junhee0110/DAYONE_drone/modeling/1590045909.jpg

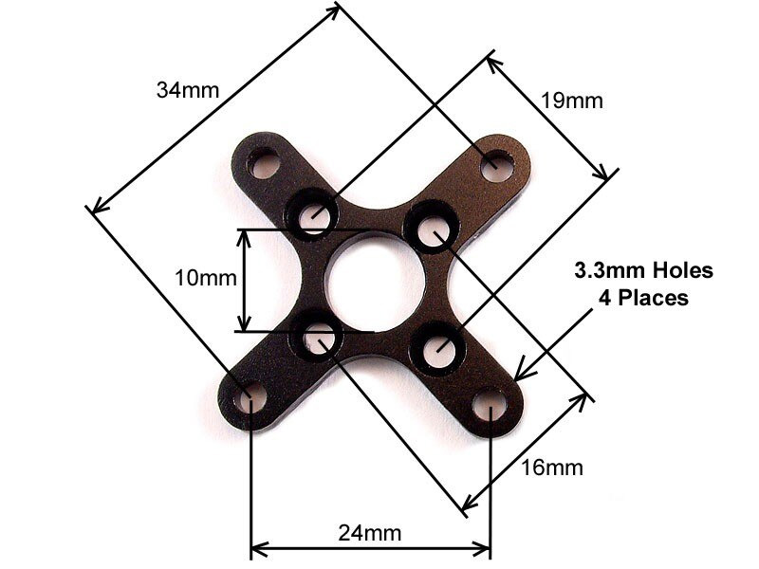
modeling/1590045909.jpg
