junhee0110/DAYONE_drone/sketch_201104a/data/background.PNG

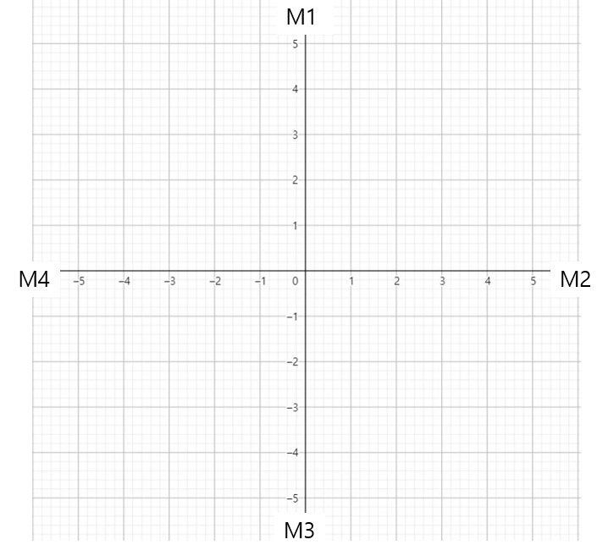
sketch_201104a/data/background.PNG
