junhee0110/DAYONE_drone/modeling/[V2.2]Drone_Body(sep).SLDASM

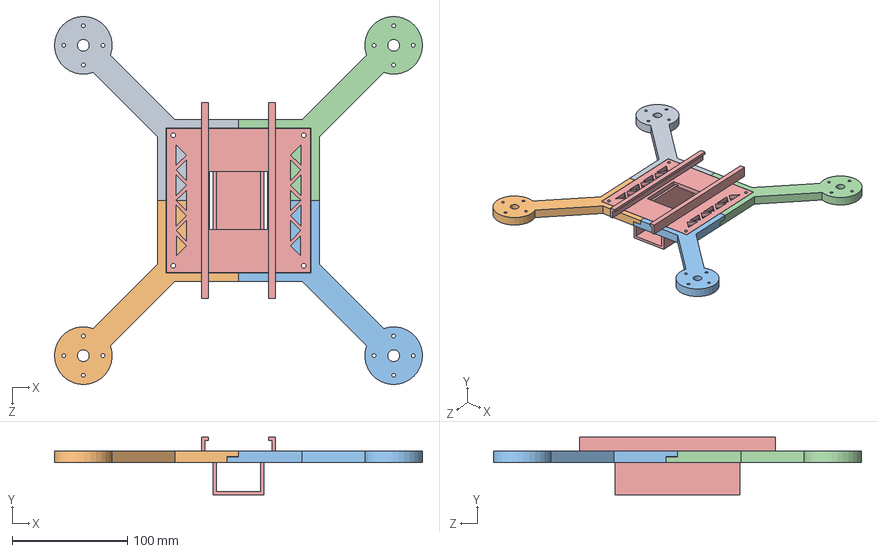
[picture p3: CAD file, 2021-02-21]
modeling/[V2.2]Drone_Body(sep).SLDASM
318.6 x 50.0 x 318.6 mm
[V2.2]Drone_Body(1)
[V2.2]Drone_Body(2)
[V2.2]Drone_Body(3)
[V2.2]Drone_Body(4)
[V2.2]Drone_FCtrl
