junhee0110/DAYONE_drone/modeling/Drone_Body.SLDASM

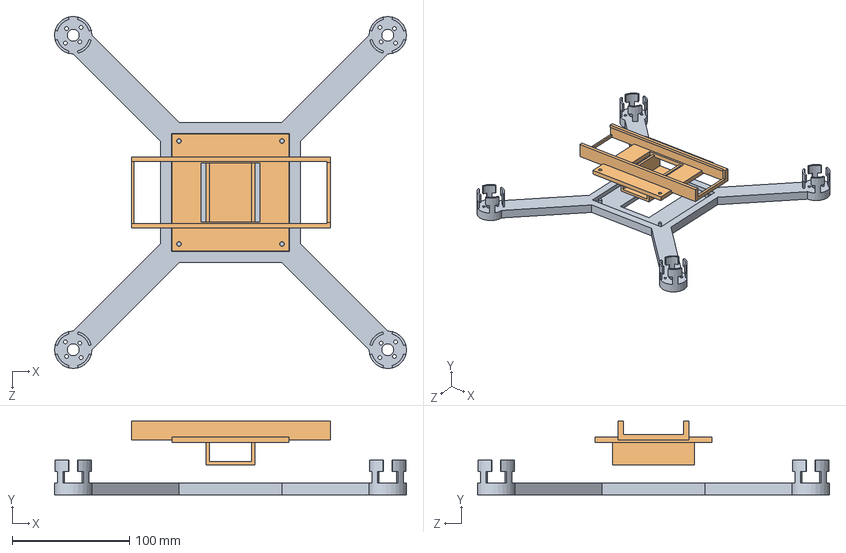
[picture p4: CAD file, 2021-01-31]
modeling/Drone_Body.SLDASM
300.7 x 63.1 x 300.7 mm
Drone_Body
Drone_FCtrl
