junhee0110/DAYONE_drone/modeling/Drone_Body(sep).SLDASM

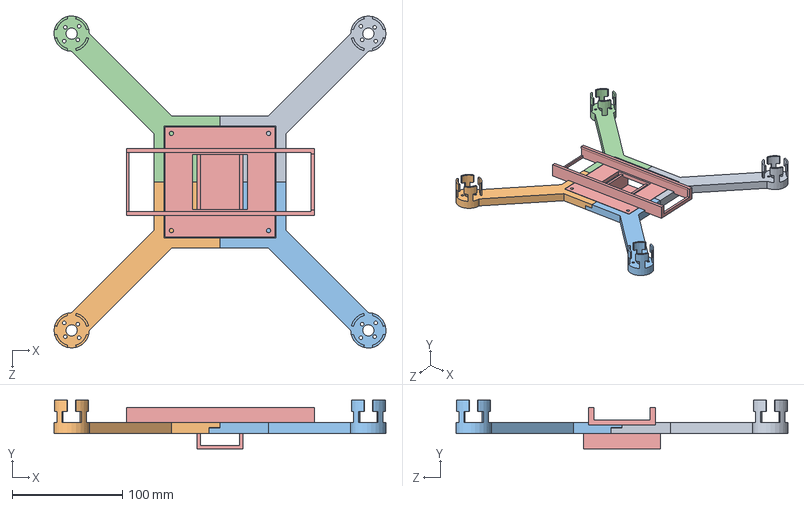
[picture p5: CAD file, 2021-01-31]
modeling/Drone_Body(sep).SLDASM
300.7 x 44.0 x 300.7 mm
Drone_Body(1)
Drone_Body(2)
Drone_Body(3)
Drone_Body(4)
Drone_FCtrl
