junhee0110/DAYONE_drone/modeling/[V2.2]Drone_Body.SLDPRT

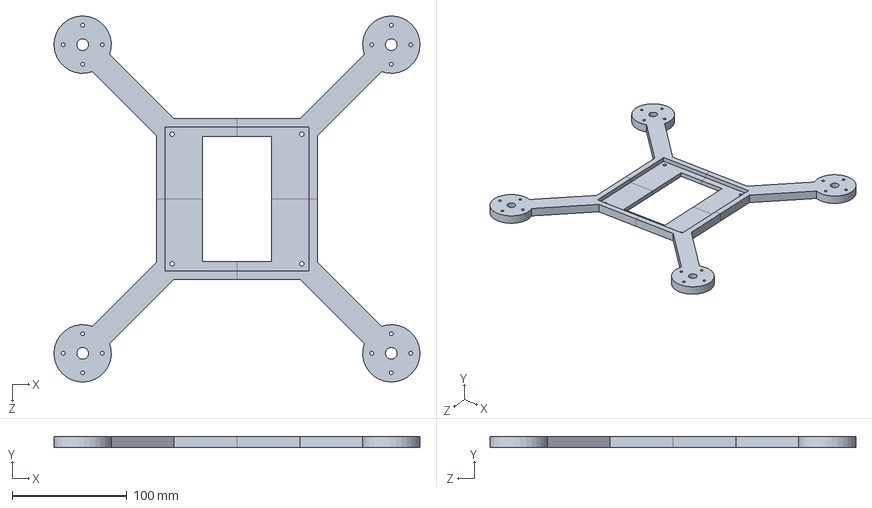
[picture p6: CAD file, 2021-02-21]
modeling/[V2.2]Drone_Body.SLDPRT
318.6 x 10.0 x 318.6 mm
