junhee0110/DAYONE_drone/modeling/STL for Printing/[V2.2]Drone_Body(1).STL

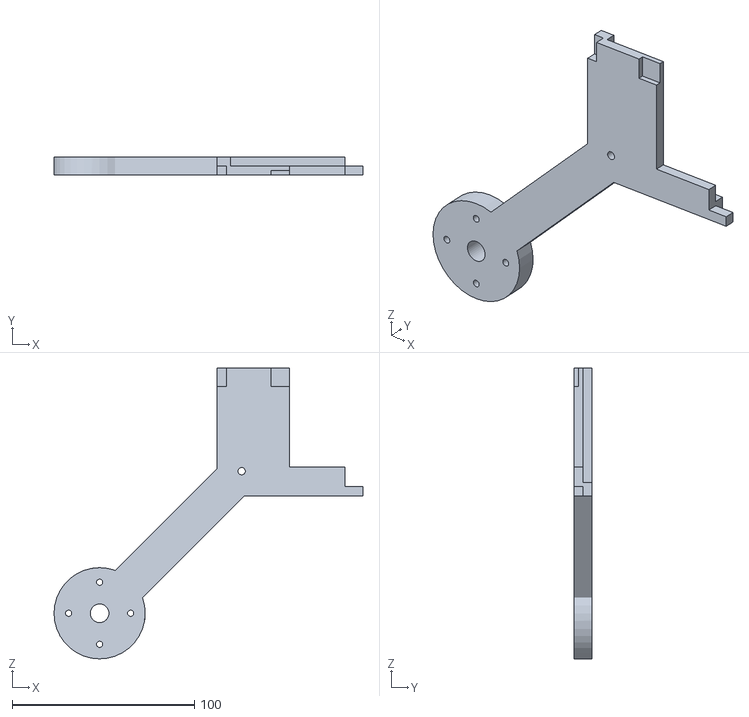
[picture p7: CAD file, 2021-02-21]
modeling/STL for Printing/[V2.2]Drone_Body(1).STL
169.4 x 10.0 x 159.4
