junhee0110/DAYONE_drone/modeling/STL for Printing/[V2.2]Drone_FCtrl.STL

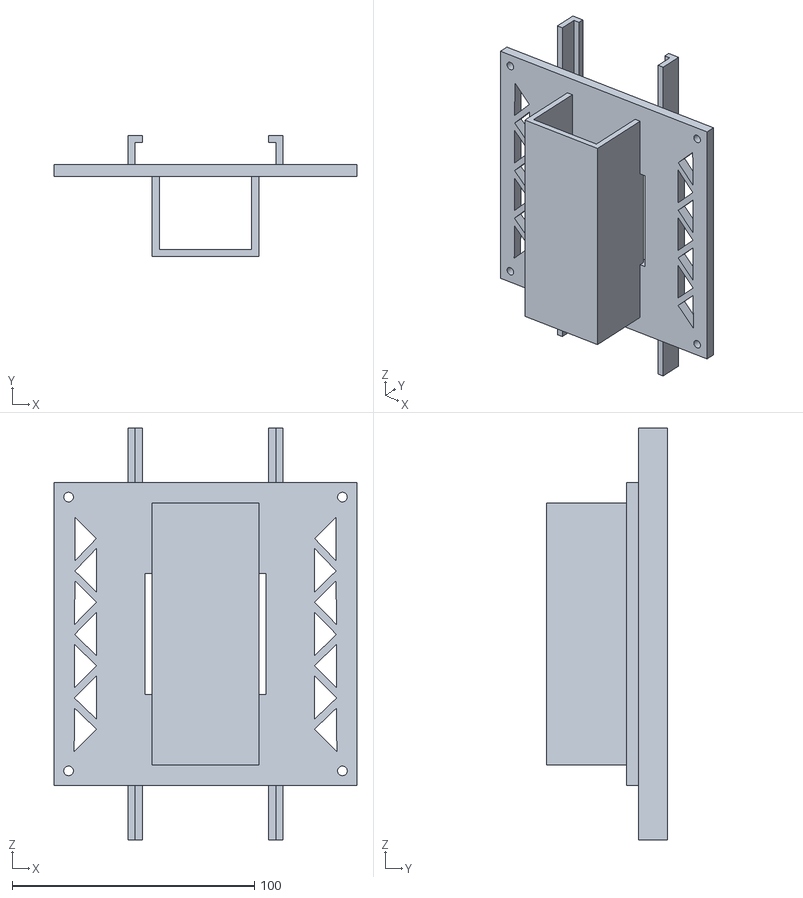
[picture p8: CAD file, 2021-02-21]
modeling/STL for Printing/[V2.2]Drone_FCtrl.STL
125.0 x 50.0 x 170.0
