junhee0110/DAYONE_drone/modeling/Drone_FCtrl(PBoard).SLDPRT

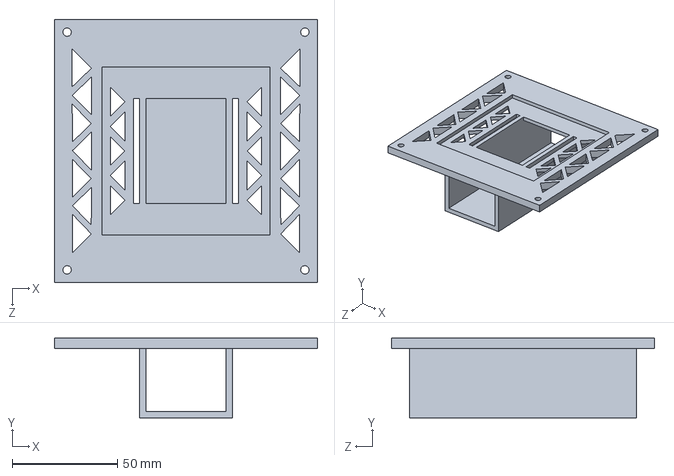
[picture p9: CAD file, 2021-02-21]
modeling/Drone_FCtrl(PBoard).SLDPRT
125.0 x 38.0 x 125.0 mm
