junhee0110/DAYONE_drone/modeling/[V2.1]Drone_Body(3).SLDPRT

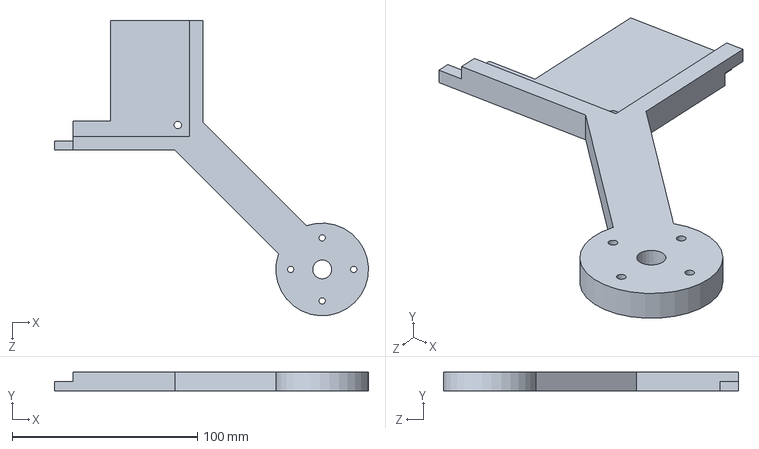
[picture p10: CAD file, 2021-02-11]
modeling/[V2.1]Drone_Body(3).SLDPRT
169.3 x 10.0 x 159.3 mm
