junhee0110/DAYONE_drone/modeling/STL for Printing/Drone_Body.STL

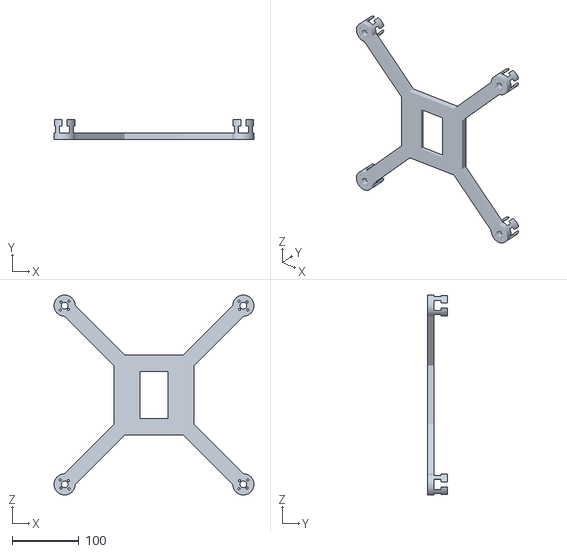
[picture p11: CAD file, 2021-01-29]
modeling/STL for Printing/Drone_Body.STL
300.7 x 30.0 x 300.7
