junhee0110/DAYONE_drone/modeling/STL for Printing/Drone_FCtrl.STL

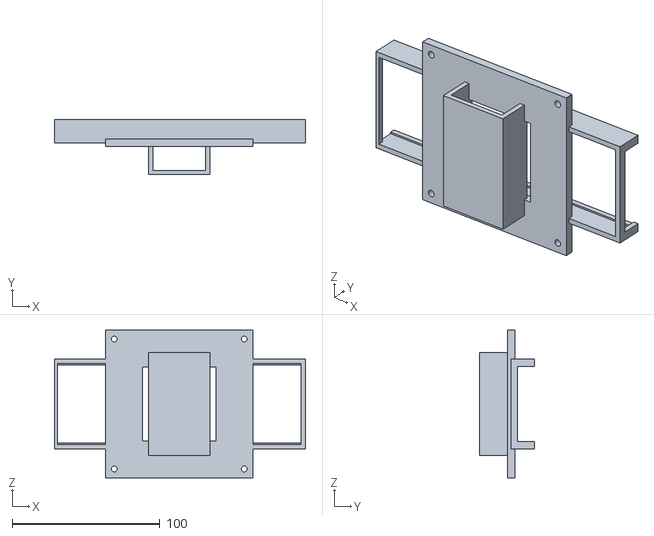
[picture p12: CAD file, 2021-01-20]
modeling/STL for Printing/Drone_FCtrl.STL
170.0 x 37.5 x 100.0
