junhee0110/DAYONE_drone/modeling/드론_모터.SLDPRT

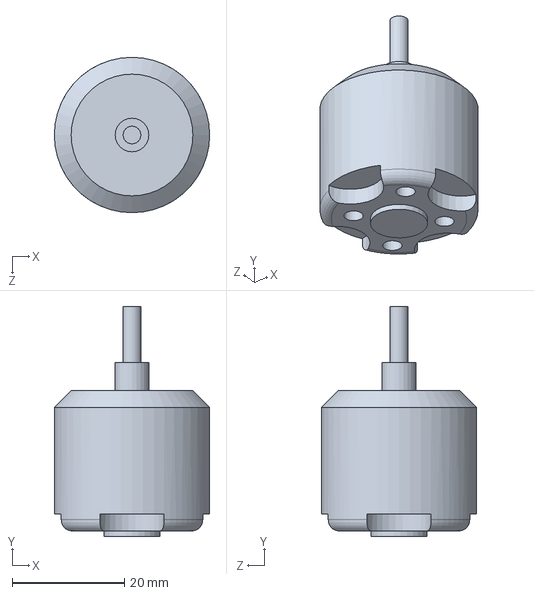
[picture p13: CAD file, 2021-01-06]
modeling/드론_모터.SLDPRT
27.7 x 41.0 x 27.7 mm
