junhee0110/DAYONE_drone/(list of files, cad)

Other CAD files:
modeling/STL for Printing/[V2.2]Drone_Body(2).STL
modeling/STL for Printing/[V2.2]Drone_Body(3).STL
modeling/STL for Printing/[V2.2]Drone_Body(4).STL
modeling/[V2.2]Drone_FCtrl.SLDPRT
modeling/[V2.1]Drone_Body(4).SLDPRT
modeling/[V2.1]Drone_Body(1).SLDPRT
modeling/[V2.1]Drone_Body(2).SLDPRT
modeling/Drone_FCtrl.SLDPRT
modeling/A2212 13 1000KV.3dm
modeling/Drone_Body(1).SLDPRT
modeling/Drone_Body(2).SLDPRT
modeling/Drone_Body(3).SLDPRT
modeling/Drone_Body(4).SLDPRT
modeling/Drone_Body.SLDPRT
modeling/Drone_FCtrl.SLDDRW
modeling/STL for Printing/Drone_Body(1).STL
modeling/STL for Printing/Drone_Body(2).STL
modeling/STL for Printing/Drone_Body(3).STL
modeling/STL for Printing/Drone_Body(4).STL
modeling/STL for Printing/[V2.1]Drone_Body(1).STL
modeling/STL for Printing/[V2.1]Drone_Body(2).STL
modeling/STL for Printing/[V2.1]Drone_Body(3).STL
modeling/STL for Printing/[V2.1]Drone_Body(4).STL
modeling/STL for Printing/[V2]Drone_Body(1).STL
modeling/STL for Printing/[V2]Drone_Body(2).STL
modeling/STL for Printing/[V2]Drone_Body(3).STL
modeling/STL for Printing/[V2]Drone_Body(4).STL
modeling/STL for Printing/[V2]Drone_FCtrl.STL
modeling/[V2.1]Drone_Body(sep).SLDASM
modeling/[V2.2]Drone_Body(1).SLDPRT
modeling/[V2.2]Drone_Body(2).SLDPRT
modeling/[V2.2]Drone_Body(3).SLDPRT
modeling/[V2.2]Drone_Body(4).SLDPRT
modeling/[V2]Drone_Body(1).SLDPRT
modeling/[V2]Drone_Body(2).SLDPRT
modeling/[V2]Drone_Body(3).SLDPRT
modeling/[V2]Drone_Body(4).SLDPRT
modeling/[V2]Drone_Body(sep).SLDASM
modeling/[V2]Drone_Body.SLDPRT
modeling/[V2]Drone_FCtrl.SLDPRT
