junhee0110/DAYONE_drone/(threads)

Thread 11 (2021-02-03):

프로젝트 진행 기록 문서 작성

junhee0110, 2021-02-03:
# 이슈 요약
2021-02-03 모임에서 이야기했듯, 이제 프로젝트 문서 작성을 확실히 하고자 합니다.
일단 지금까지의 기록을 제가 정리할 예정입니다.

# 이슈 발행 배경
시간이 오래 지나면서 우리의 초기 기획안을 다들 잊어버리고 있기도하고, 그것을 명확하게 기록해두지 않아 소통에 문제가 생긴 경우가 많았습니다. 또한, 우리의 시행착오와 아이디어를 기록해두는 편이 앞으로도 도움이 될 것같아서 프로젝트의 결과와 과정에 대한 문서를 확실히 작성하고자 합니다.

# 이슈 설명
프로젝트 문서에는 다음과 같은 내용을 작성합니다.
- 초기 아이디어 및 목표
- 사용하고 있는 부품
- 소프트웨어 설명
- 시행착오 및 해결

지금까지의 내용은 제가 작성하지만, 앞으로의 작성을 위해서 여러분이 틈틈히 작성을 해주셔야 합니다.
다음과 같이 작성 부탁드립니다.
- 작성하고 있는 프로그램 코드의 상단에 주석으로 설명기재
- 현재 진행하고 있는 작업을 Issue에 상세히 기록
- 문제가 생기거나 도움이 필요할 때 Issue에 상세히 기록
- Issue 발행시 레퍼런스도 기록

**결국 핵심은 Issue를 상세히 기록하는 것이니 동참바랍니다!!**

Thread 12 (2021-02-03):

[Modeling] Test 기체 팔 부분 재설계 요청

junhee0110, 2021-02-03:
# 이슈 개요
현재 팔 하나를 출력했는데, 모터를 감싸는 부분이 너무 얇습니다 ㅠㅠㅠ
아예 없애거나 두껍게 재 설계를 해야할것같아요...

# 이슈 발생 배경
방금 막 출력물 하나가 나왔는데 모터를 감싸는 부분이 뽀각하고 뿌러졌습니다...
다른 부분은 정상적으로 잘 나왔습니다. 튼튼하고요.
잘린 단면으로 보니 너무 얇아서 내부 채움이 충분하지 않게 된거같아요.

# 요청 사항
우선 관련된 프린팅 설정을 바꿔서 다시 출력할 예정입니다.
하지만, 이로 인해 다른 부분의 퀄리티가 조금 바뀔 수 있어요... 심한 경우에는 효과가 없을 수도 있습니다.

이렇게 될 경우를 대비해서 모델을 어떻게 수정할지 미리 논의했으면 합니다.
나사 구멍이 있어서 그냥 감싸는 부분을 없애도 될것같기도 해요. 혹은 두께를 좀 늘리거나...
어떻게 생각하는지 코맨트 부탁드립니다.

junhee0110, 2021-02-04:
# 새 출력물 보고
line width라는 설정을 25%정도 늘려 0.75mm로 설정했습니다. [Reference](https://3dprinterly.com/how-to-get-the-perfect-layer-height-setting/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)

현재 Nozzle Size가 0.6mm이므로 line width가 0.75가 되면 출력물이 다음과 같이 됩니다.
1. 강도가 높아짐
2. 출력 속도가 빨리짐
3. 정밀도가 떨어짐

정밀도에는 큰 문제가 없었으나, 출력물의 강도가 높아지며 인성이 감소하여 다시 한번 모터를 감싸는 부분이 부숴졌습니다.

# 프린팅 예정
아래의 3가지 시도를 해볼 예정입니다.
1. line width를 0.4mm로 조정 => 강도는 좀 떨어지지만, 인성이 커지길 기대
2. line width를 0.9mm로 조정 => 이렇게 출력하면, 벽과 내부 채움의 간격이 사라짐
3. line width를 0.6mm로 재 출력 => 첫 시도할때의 실수를 의심

아마 피드백을 주시기 전까지 1번 시도까지는 가능할 것 같습니다.. 또 보고 드리겠습니다.

aquarius0122, 2021-02-04:
모터의 전선이 드론 안쪽 방향으로, 팔을 따라서 나와야 하는데 나사 구멍을 어떻게 뚫어야 원하는 각도로 고정할 수 있는지 먼저 확인해야 합니다. 나사 구멍을 조절하게 되면 (사방이 아니라) 전선이 나오는 일부분만 뚫어서 위에서 봤을 때 C자 형태로 수정할 수 있겠죠. 두께도 약간 늘리고 모따기 등을 활용하여 보강대도 설치할 예정입니다. 이렇게 모터 감싸는 부분을 수정하면 부러지는 문제는 충분히 해결할 수 있을 것입니다. 직접적으로 힘을 받는 부분이 아닌 외부 이물질을 막기 위해 설계한 것이므로 크게 신경쓰지 않아도 됩니다.

다만 프로토타입인 만큼 가공 과정에서 부러졌다면 부러진 대로 나사만 박아 사용해도 무방할 것입니다. 따라서 정밀도에 대해서 이번에는 크게 신경쓰지 않아도 될 것 같습니다.

이전에 이야기했었는데, 출력물의 원형 구멍이 제대로 표현되지 않는 문제가 있다고 알고 있습니다. 그렇게 되면 출력물의 나사 구멍이 실제 나사 고정에 부적합할 수도 있겠다는 생각이 드는데, Nozzle Size나 Line Width와 상관없이 FFF 방식 3D 프린팅 출력물에서 공통적으로 발생하는 문제입니다. 보강할 방법을 생각해 보면 좋을 것 같습니다.

이번 분할 출력물에서 접착과 조립의 편의를 위해 파트 사이에 사각기둥 형태의 요철을 도입했는데 실제로 조립해 보고 의견을 알려주길 바랍니다. 문제가 있다면 다른 방법을 생각해 보도록 하겠습니다.

junhee0110, 2021-02-04:
우선 전선은 나사 구멍의 사이(?)로 나옵니다. 사진을 함께 첨부합니다.
그래서 실제 기체에서는 나사 구멍의 배열을 45도 회전시키면 선들이 팔을 타고 FC로 연결될 수 있을 것 같습니다. 그렇게 된다면 C자 형태로 가림막을 설치하는 것은 매우 좋은 아이디어 같습니다. 또한 C자 형태로 이어진다면 부러지는 문제도 보완이 될것같습니다 :)

지금 가림막이 부러지는 건... 진짜 툭 건들면 부러지는 수준입니다. 당장 테스트 기체에서는 큰 의미가 없는 것 같으니 부러지면 부러지는대로 사용을 하겠습니다.

가림막을 제외한 나머지 부분은 정밀도와 강도가 우수합니다! 말씀하신대로, 원형 구멍이 다른 부분과 비교했을때 조금 취약한 것은 사실이지만 원형을 유지하고있습니다. 그냥 사용해도 문제가 없을 것이라고 생각합니다. 이 역시 사진을 첨부하겠습니다. 이 정도면은 나사를 사용하는 과정에서 표면이 정돈될 것이라고 생각합니다. 다만, 문제가 될 법한 부분은 **내부 채움**과 **구멍** 사이의 간격이 조금 걱정되긴합니다만, 상부 표면에만 갈라짐이 조금 있어서 후가공을 하는 과정에서 채워넣을 수 있을 것 같습니다.

하나당 출력시간이 8시간으로, 아마 4개를 다 출력해서 월요일 워크타임에 보여드릴 수 있을 것 같습니다!

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

Closed 2021-02-11.

Thread 4 (2021-02-03):

[Communication] 양방향 통신 관련 이슈

junhee0110, 2021-02-03:
# 제안 개요
통신 파트를 수정해서 양방향통신이 가능하게 만들어야할 것 같아요!

# 제안한 이유
제가 하나의 class로 뭉쳐달라고 한 요청이 완료됐었고, 이를 검토하고 있었습니다1
Pull requests로 올라온 통신 코드를 쭉 읽어보았는데, init함수를 무엇을 고르냐에 따라 송신기인지 수신기인지 선택되는 구조더라구요.
하지만 저희가 계획한 대로면, 드론은 조종기로 부터 데이터를 **수신**하고, 비행상태를 조종기로 다시 **수신**해야 하는데 지금 코드대로는 그렇게 작동할 수 없을 것 같습니다.

# 요약
1. 하나의 클래스에 송/수신이 모두 담겨있음
2. 하지만 구조상 송신 또는 수신밖에 안됨
3. 수정하여 양방향으로 통신되게 해야함

dhguswn, 2021-02-03:
시도 해보겠습니다...

Thread 5 (2021-02-03):

[Manufacture] 배터리 구입

junhee0110, 2021-02-03:
# 이슈 요약
기존에 있던 배터리가 수명이 다해서 새로운 것을 구입해야합니다.
# 이슈 발행 배경
기존에 있던 배터리를 충전 시킬때, 빨간 점멸등이 들어왔다.
배터리 전압이 1V이하로 매우 저전압이었다.
구글링을 해보니 이 정도 전압이면 과방전상태로 재사용이 불가능하다고 한다.
따라서 새로운 배터리를 구입해야 한다.
# 요약
1. 우리 배터리가 과방전이 되었다.
2. 배터리 없으면 진행이 안된다.
3. 새로운 배터리를 구입해야한다.

junhee0110, 2021-02-03:
# 주문 완료
[팰콘샵](http://www.falconshop.co.kr/shop/goods/goods_list.php?category=019003040)
**[NANO-TECH] 11.1V 2200mAh 35C 리튬 폴리머 배터리 (XT60잭)** 주문했습니다!

# 배터리 스펙
- 전압 : 3S(11.1V)
- 용량 : 2,200mAh
- 표준 방전률 : 35C => 77A 지속적으로 출력가능
- 최대 중전률 : 5C => 최대 11A로 출력가능 (우리 충전기는 2A or 5A 사용중)
- 무게 : 187g
- 규격 : 107*33*25 (mm)

junhee0110, 2021-02-06:
배터리가 잘 도착했고, 기존에 가지고 있던 충전기로 충전중입니다.
이번에는 빨간불이 들어왔습니다. 즉, 정상적으로 충전중입니다.

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

이번 이슈에서 저희가 주목해야할 것은 다음과 같습니다.
1. 배터리의 각셀당 2.7V 아래로 전압이 내려가면 과방전이 되어 사용할 수 없게된다,.
2. 배터리의 각 셀당 공칭전압은 3.7V이지만, 만충전압은 4.2V이다. 그 이상으로 충전되면 과충전이 된다.
3. 즉 우리가 쓰는 배터리의 전압이 5.1V~12.6V 사이가 되도록 유지해야한다.

아마, 이전 배터리를 사용했던 팀이 과방전 방지를 하지 않아서 배터리가 수명을 다한것 같습니다.
앞으로 과방전을 방지하기 위한 방법을 논의해봐야하겠습니다.

배터리가 완충되면 사진을 올려 보고하고 이 이슈는 닫도록 하겠습니다.

@Hmiru  @dhguswn  @t1207a  @aquarius0122

junhee0110, 2021-02-06:
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

충전 완료되었습니다. 이슈 닫겠습니다!

Closed 2021-02-06.

Thread 6 (2021-02-03):

모터 구동

Hmiru, 2021-02-03:
## 이슈 요약
모터의 본격적인 사용 전 캘리브레이션 완료하기.
받아온 PID값을 모터와 연결하기.

## 이슈 발행 배경
BLDC 모터와 변속기의 주파수를 맞추어주는 과정이 있어야 ESC를 연결했을때 작동하기 때문이다.

## 계획
미리 코드를 준비해놓은 다음
배터리가 배송된 이후 준희와 만나 코드 테스트

Hmiru, 2021-02-03:
캘리브레이션에 대한 감을 잡았습니다.

Thread 7 (2021-02-03):

[Sensor] Barometer로 높이 측정

junhee0110, 2021-02-03:
# 이슈 요약
최근 GY86 모델로부터 센서값을 받아오는 것을 Class로 구현해두었습니다.
하지만 Barometer로 기체의 높이를 측정하는 부분은 구현을 하지 않았습니다.
기체의 높이도 측정을 할 것인지 논의하고 싶습니다.

# 이슈 발행 배경
높이를 측정하여 높이로 PID제어를 하면 보다 정확한 호버링이 가능합니다.
또한 조종사에게 높이 데이터를 보내 시각화 하는 것이 도움이 될것같습니다.

# 3줄 요약
1. 아직 높이 측정은 안 만들었다. (금방 만들 수 있음)
2. 높이로도 PID제어를 할 수 있고, 시각화하면 도움이 될 수 있음
3. 이거 쓸지 말지 논의하고 싶음

Thread 8 (2021-02-03):

이중 pid구현

t1207a, 2021-02-03:
#이슈 요약
1. 이중 pid 내용은 전반적으로 이해하고 c언어를 통해 이를 구현하는 것까지는 완료 (but 실제로 제대로 작동되는 지는 아직 의문)
지금 진행 프로젝트는 C++로 진행되고 있기에 언어를 바꿔 수행하여야함.
2. 지자기 센서가 x,y,z를 출력하는데 이를 모두 제어하면 yaw가 제어되는 지 제대로 이해하지 못함

#이슈 발행 배경
지자기 센서를 어떻게 제어해야 하는 지 아직 감이 잡히지 않음
다른 축 (roll, pitch)는 각 축에 대한 각속도와 각을 받아오면 됐었지만 yaw는 각 x,y,z에 대해 모두 pid를 한 것을 어떻게 처리하는 지 이해가 되지 않았음

#계획
1. 지자기 센서에 대한 이해 필요
2. 제어기 코드 C++로 변환

Thread 9 (2021-02-03):

지자기 센서를 활용한 YAW축 제어 질문

t1207a, 2021-02-03:
# 질문
X,Y,Z에 대한 출력 값 생성 후 제어기에 넣으면 각 축을 제어하게 될 것임 X,Y,Z에 대한 출력 값이 나오게 될 건데 이후에 어떻게 해야하는지에 대한 질문

junhee0110, 2021-02-03:
# 답변

우선, 현재 지자기 센서로 YAW값을 추출하는 것은 이미 구현이 되있으니 걱정할 필요 없습니다!
간단히 원리를 설명하자면, 지구 자기장이 북쪽을 향한다는 것을 이용합니다.
 X,Y,Z축으로 분리된 자기장 값을 수학적으로 계산하여, 북쪽 기준으로 각도를 계산합니다.

우리 소스코드에서는 sensor파트에 gy86::get_heading()이라는 매소드로 구현이 되어있고, YAW값을 사용하기 위해서는 gy86::get_head() 매소드로 값을 return받으면 됩니다.

Closed 2021-02-08.

Thread 13 (2021-02-06):

테스트 기체 몸통 배터리 수납칸 재설계 요청

junhee0110, 2021-02-06:
# 이슈 요약

이슈 #5에서 배터리를 새로 구입하게 되면서, 배터리의 크기가 커졌습니다. ㅠㅠㅠ
그래서 현재 몸통 부분에 배터리를 수납할 수가 없습니다.
다행히, 배터리 수납부의 높이를 적당히 키우면 수납이 가능할 것 같습니다.

# 요청 사항

현재 드론 팔이 3개 뽑혀있어서, 다시 뽑기에는 시간과 재료가 너무 아깝습니다...
하지만 배터리의 사이즈가 엄청 큰 것은 아니여서, 드론 팔은 그대로 하고 몸체의 배터리 수납부만 조금 수정하면 수납이 가능할 것 같습니다.

배터리 Dimension은 107 * 33 * 25 mm입니다.

확인 후 답변 부탁드립니다....

aquarius0122, 2021-02-06:
생각보다 어려운 문제가 되네요. 기존 설계 규격은 70 * 35.5 * 16이었는데 FC부분 뿐 아니라 Body에 뚫린 구멍까지 수정해야 되겠어요.
지금 FC부분 한 변이 100mm라 107이 되면 넘쳐버리는데 설계를 아예 바꿔버려야 할 것 같습니다.

다만, 역시 이번에도 프로토타입이니까 원래 튀어나와 있던 수납부는 깎아버리고, FC를 Body에 조립한 채로 양면테이프나 청테이프로 붙여버리는 건 어떨까요?

월요일까지 신경써야 할 중요한 일이 있어서 지금 바로 설계변경은 좀 곤란합니다. 변경을 한다 하더라도 출력에 시간이 걸리는 만큼 새로 제작하는 건 바람직하지 않아 보여요. 추후 정식 설계 때 반영하겠습니다.

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

aquarius0122, 2021-02-10:
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

모든 추가사항을 반영하여 재설계했습니다. 가장 문제 되던 빵판 간섭 관련하여 이번에는 문제 없음을 확인했습니다.

큰 변동사항은 없으나 부품 고정을 위해 3.3pi 구멍을 뚫었으니 FC와 Body 결합 시 **M3 규격 볼트 및 너트**로 체결하시기 바랍니다.

STL 파일도 업로드했으니 참고하시기 바랍니다.

junhee0110, 2021-02-10:
죄송합니다 ㅠㅠㅠ 뻘짓하느라 좀 늦게 확인했습니다 ㅠㅠㅠ
다음의 문제를 발견했습니다.

## 모터 가림막 사이즈가 너무 작습니다...
직접 측정해봤을 때, 모터의 지름은 28mm입니다.
현재 모터 가림막의 내경은 27.8mm인 것 같습니다.
게다가 저희 모터가 통돌이 형 모터라서 **옆면이 회전합니다.**
그래서 가림막과 모터 사이에 공간이 조금 필요할 것 같습니다.

## 지금의 구조로는 모터를 나사로 직접 결합할 수 없습니다.
나사 머리의 둘레가 약 5.5mm이라서 나사가 모터까지 깊게 들어갈 수 없습니다.
어떻게 수정해야하는지 답은 찾았는데, 글로는 설명하기가 힘들 것 같습니다..
나사 사진을 첨부합니다.

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

보니까 3.3pi 원을 20도의 taper angle로 2mm를 cut하면 되는 것 같았습니다..! (용어가 맞는지를 모르겠습니다...)

## 몸통과 날개를 연결하는 원기둥과 구멍의 크기가 너무 작습니다.

오늘 시험삼아 결합할 때 4개의 원기둥이 다 뿌러졌습니다... 조금 더 키워야할 것 같습니다..!

당장은 이 정도만 수정되면, 조립에 문제가 없을 것 같습니다!!
혹시 설 연휴 스케줄이 많으시면 제가 직접 수정하도록 하겠습니다!!
코멘트 부탁드립니다

@aquarius0122

aquarius0122, 2021-02-10:
실물이 없으니 복잡하네요.

M3.3 나사는 비규격이네요. 카운터보어나 카운터싱크를 적용하더라도 더 긴 나사를 사용할 수는 없을 것이니 직접 모터를 동체에 고정시키는 건 어렵겠어요. 어쨌든 십자 지지대를 (끝까지) 써야 할 것 같고, 따라서 보호벽도 없애버리는게 낫겠습니다.

FC랑 Body 고정하려 했던 원통은 이번 버전에서 제거했으니 M3/M4 볼트-너트로 고정하면 되겠습니다.

십자 지지대를 끼울 수 있도록 동체만 고치도록 할게요. 일단은 새로운 FC부터 출력하면 좋을 것 같습니다.

junhee0110, 2021-02-10:
아! 원통이 제거된건 미쳐 확인을 못했네요! 바로 FC 출력하도록 하겠습니다!

aquarius0122, 2021-02-11:
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

보호벽 제거했고, 모터 고정 나사도 간격 34가 되도록 고쳤습니다.
확인 후 출력해 주시기 바랍니다.

'STL for Printing' 폴더에서 바로 출력 시 버전에 유의하세요. **현재 최신 버전의 FC는 V2, Body는 V2.1입니다.**

junhee0110, 2021-02-11:
수정사항 확인했습니다!!!
바로 출력시작하겠습니다!!

그리고 몸통을 출력했는데 서포트 제거과정에서 파손되어서 다시 출력하겠습니다 ㅠㅠㅠㅠㅠ
강도관련 설정을 거의 최대로 높였더니 서포트도 너무 단단하게 나와서 그런것 같습니다 ㅠㅠㅠ

aquarius0122, 2021-02-21:
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

**V2.2 버전** 업데이트했습니다. FC의 배터리 수납부 내부를 38 * 30로 확장시켰습니다.
추후 배터리 변경에도 대응할 수 있도록 Body의 구멍도 60까지 넓혀놨습니다.
V2.1 출력물을 사용할 수 있다면 지금 출력할 필요는 없겠으나 앞으로는 이 dimension 기반으로 작업하면 되겠습니다.

Thread 15 (2021-02-09):

조종기 만들 때 고려사항

dhguswn, 2021-02-09:
### 이슈 요약

여러 자료를 조사해본 바에 의하면 조종기가 수행해야할 기능으로는 크게 4가지가 있다.

1. 조이스틱 값을 이용한 드론 위치 조정
2. 통신기기와 드론과의 페어링
3. 드론을 완전히 정지시킬 때 모터 자체를 꺼버리는 기능
4. 드론 비행 시작 전에 드론이 의도하고자 하는 방향으로 똑바로 날아가는지 체크하는 트리밍 기능

### 앞으로의 계획

1. 위의 기능 1번을 수행하기 위한 조이스틱 2개 외에 위의 2,3,4 기능을 수행 하기 위한 별도의 버튼이 필요할 것으로 예상-> 택트 스위치를 고려중
2. 버튼과 조이스틱이 늘어남에 따라 조종기 별도의 회로 설계 등이 필요해보임
3. 명절로 인해 이번 주에는 부품을 구하기가 힘들어보임 빠르면 다음주 월요일에 부품을 구하러 갈것임

Thread 16 (2021-02-16):

조종기 진행상항 및 시행착오

dhguswn, 2021-02-16:
### 진행상황

- 통신 모듈을 이용하여 2개의 조이스틱 값을 주고 받는 데에 성공함
지난 회의에서 매핑 범위를 700에서 2000사이로 정함
다만 nRF24L01 통신모듈은 8bit(0~256)의 값만 주고 받을 수 있기 때문에 700부터 2000까지의 넓은 범위를 섬세하게 제어하는 것은 조금 힘들어 보임, 작동에는 문제가 없음

- 정지 기능과 트리밍 기능은 모터에 대한 이해가 필요한 부분이므로 도움이 필요함

### 시행착오

-nRF24L01의 데이터의 송신과 수신시  데이터형은 char(문자 8bit),byte(숫자 8bit,부호 없음)형만 허용하므로 생각보다 한번에 크기가 큰 데이터를 전송하기는 힘든 것을 알았음.

junhee0110, 2021-02-16:
# Mapping 관련 코멘트

조이스틱으로는 총 4개의 데이터를 받아옵니다. **Thrust, Yaw, Pitch, Roll**
이때 700~2000 사이로 mapping 되어야 하는 것은 **Thrust** 하나 입니다.
게다가 **Thrust**값은 어차피 PID로 보정되기 때문에 굳이 정밀할 필요는 없습니다!!

**Pitch**, **Roll**은 **최소각도 ~ 최대각도**로 Mapping 됩니다. 예를들어 30도로 설정한다면, -30~30으로 mapping 됩니다.
이 값은 8bit보다 작아서 정밀 제어가 가능합니다.

**Yaw**도 **Pitch**, **Roll**과 비슷하지만 조금 다릅니다. 아무튼 8bit보다 작은 값이라는 것을 알아주시길 바랍니다!!

질문이 있으시다면 코멘트바랍니다!

Thread 17 (2021-02-18):

진행도 20-02-18 중간 정리!!🔥🔥🔥

junhee0110, 2021-02-18:
# 이슈 개요
현재 논의 사항이 크게 없어, 각자 작업을 진행하고 있습니다.
여러분들이 작성한 이슈를 기반으로 지금까지의 진행도를 정리하도록 하겠습니다.

# GitHub 개편 이전

## PID part

PID의 기본 아이디어에 따라, Sampling Time(dt) 측정, 미분기, 적분기, 오차 측정 함수 등을 만들어 PID 값을 계산하는 Class를 제작해 두었습니다. 다만, Sampling Time이 너무 짧아서 millis(), micros() 함수로 측정이 힘들다는 문제를 발견했습니다.

하지만, delay() 함수를 쓰거나, main loop에서 다른 연산들로 인해 Sampling Time이 길어져 측정하는데 무리가 없을 것이라고 예측하며 문제를 개선시키지 않았습니다.

## Control Part

PID Value를 모터의 Output 값에 더하거나 빼기 위해서 **모터 번호**라는 아이디어를 도입했습니다. 이 아이디어는 모터의 번호로부터 모터의 위치를 알아내어 PID값을 더할지 뺄지 판단하기 쉽도록 하는 아이디어였습니다.

그 외에 추가적인 사항은 없었고, 각 Motor를 제어하기 위한 class 작성을 계획하고 있었습니다.

## Communication Part

무선 통신 모듈로 통신 기능을 구현했습니다.
하지만 송신 기능과 수신 기능을 별개의 class로 제작하여, class의 구조를 변경시켜 달라는 요청을 했습니다. (기능별이 아닌 부품별로 class를 설계하고 있으므로)

그래서 class를 재설계하여 두 가지 기능을 한 class내에 성공적으로 합쳤으나, 설계된 대로라면 단 방향통신 밖에 할 수 없다는 문제를 발견했습니다.

## Sensor Part

GY-86때문에 많은 고생을 했습니다... 처음에는 GY-86이 작동조차 하지 않았습니다... 하지만 이는 제품 문제인 것으로 학인되었고 부품을 새로 구입하여 성공적으로 **가속도, 각속도, 지자기, 온도, 기압**의 11개의 센서 값을 받아오는 데 성공했습니다.

하지만 가속도, 각속도, 지자기 값 그 자체로는 의미가 없다는 것을 깨달았습니다(당연하지만...). 그래서 이 3가지 값으로 드론 기체의 자세(YAW, PITCH, ROLL 각도)를 알아내는 작업을 진행했습니다. YAW는 지자기 센서로 계산하면 되는 간단한 문제였고, PITCH와 ROLL은 가속도와 각속도를 **상보 필터**로 계산하려고 했습니다(칼만 필터도 시도했으나 이해를 못해서 포기했습니다).

각속도로 각도를 계산하기 위해서는 Sampling Time을 구하는 과정이 필요한데, PID Part에서 언급했듯이 이를 구하는데 문제가 있어서 상보필터를 포기하게 되었고, MPU6050의 **DMP6**기능을 사용하여 각도 값을 받아오기로 결정했습니다. 그리고 테스트 결과 DMP6는 꽤 정밀하다는 것을 확인했습니다.

하지만 지자기 값을 받기 위해 I2C통신을 하는 것과 DMP6사용이 동시에 되지 않는 문제가 발견되어 오랫동안 진전이 없었다가 코드를 재 작성하여 이를 해결했습니다. (문제가 뭔지는 아직도 모릅니다)

Sensor Part가 제 담당이라서 좀 길게 작성했네요..

# Github 개편 이후

GitHub를 개편하고 난 뒤는 Issues라는 좋은 기능이 생겼으니, 이를 기반으로 진행도를 정리하겠습니다.

## 배터리 구입

이슈 #5 입니다.

기존의 배터리가 충전되지 않는 문제가 있었습니다. 인터넷에서 조사한대로 충전기에 계속 연결해두었지만 충전이 되지 않았습니다.. 조사 결과 배터리가 **과방전**되었다는 것을 확인했고 배터리를 새로 구입했습니다. 그리고 배터리 과방전 및 과충전을 방지하기 위한 기능을 마련해야 한다고 제안했습니다.

## Test 비행 준비

Git Hub 개편 직전에, 우리가 제작한 FC가 잘 동작하는지 확인하기 위해서 간단한 시험 기체를 만들기로 했습니다.
회로를 테스트하기 위해서 브레드보드를 장착할 수 있도록 했습니다.

이슈 #12 에서 기체의 팔 부분에 있는 모터 가림막이 너무 얇아서 쉽게 파손된다는 문제가 발견되었고, 우선은 테스트 모델에서는 파손된 대로 사용하고, 실제 기체에서 이를 개선하기로 했습니다.

이슈 #13 에서는 기체의 배터리가 교체되면서 수납칸의 사이즈를 변경해야하는 문제가 생겼습니다. 추가로 몸통과 팔 부분이 결합되지 못하게 설계되었다는 것을 발견했고, 몸통과 팔 부분의 조인트의 크기가 작아 쉽게 파손된다는 문제 또한 발견되었습니다. 그리고 새롭게 설계 모터 가림막이 너무 작아서 모터 회전을 방해하는 것, 모터를 팔에 고정할 수 없는 설계상의 문제가 발견되었습니다.

우선 모터 가림막은 제거하고, 모터와 함께 배송된 모터지지대를 사용하는 방법으로 문제를 해결했습니다.

현재 테스트 모델의 5개 파트가 모두 출력되었고 후가공 중 입니다.

## 이중 루프 PID 도입

이슈 #8 입니다.

이전에 작성한 PID 코드는 목표 각도와 그 오차를 이용하는 단일 루프 PID였습니다.
하지만 목표 각도와 목표 각속도를 이용하는 이중 루프 PID가 많이 이용하기 때문에 이중 루프 PID가 가능하도록 코드를 수정했습니다. 현재는 PID Part가 완성된 상태입니다.

## Motor 구동

이슈 #6 입니다.

배터리가 확보되어 드디어 모터를 시험할 수 있게 되었습니다.
구입한 ESC를 700~2000사이로 보정했으며, Motor를 작동시키는 class를 Servo 라이브러리를 상속받아 만들었습니다.

이는 기존의 control 파트에 구현되어야 했으나, motor 파트로 옮겼습니다.

## Control 파트 재설계

구두로 논의되었고, 곧 이슈로 작성될 예정입니다.

기존 계획은 PID와 Motor를 main loop에서 직접 상호작용 하도록 할 계획이었습니다.
하지만 이는 복잡하고 여러 문제를 수반한다고 생각되어, PID와 Motor를 연결시켜주는 Control 계층을 설계하기로 결정했습니다.

Control 계층은 Sensor로 부터 기체의 자세 값을 받아온 뒤, 각 축 마다 PID값을 계산하고, 이 값을 이용하여 Motor의 Output을 보정하는 역할을 수행합니다.

## 조종기 제작 및 양방향 통신

이슈 #4 #10 #15 #16 입니다.

아두이노로 조종기를 제작하고, 조이스틱에서 받아온 아날로그 값들을 어떻게 Mapping하여 드론에게 명령할지 논의 중입니다.
또한 단방향 통신만을 지원하는 통신 모듈로 양방향 통신을 하는 방법을 조사하고 구현하고 있습니다.

# 정리

조금 느리다고 생각할지 모르겠지만, 천천히 완성을 향해 다가가고 있습니다!
이제 Control Part와 Communication Part를 완성시키고 PID 튜닝을 하면 드론이 첫 비행을 할 준비가 끝납니다!!

우리 조금만 더 힘내서 합시다!!

질문 사항이 있거나 글에 수정할 내용이 있으면 코멘트 부탁드립니다!!

Closed 2021-05-17.

Thread 22 (2021-05-25):

드론 테스트 기체 재설계

junhee0110, 2021-05-25:
# 작업 개요

전임자가 이미 테스트 기체를 설계했고, 이를 3D 프린팅으로 출력했습니다. (issue #13)
그리고 최근 출력해둔 기체가 파손되었습니다.
또한 각 파츠의 크기가 너무 크기도 하고, 여러가지로 3D프린팅에는 적절하지 않습니다.
그래서 이전의 문제점을 개선하면서 기체를 재설계하려고 합니다.

# 체크 리스트

확인 해야 할 것, 해야 할 것 리스트를 작성해주세요.
- [x] 드론 팔
- [x] FC 수납부
- [x] 배터리 수납부
- [x] 각 부분 연결

junhee0110, 2021-07-11:
드론 기체 출력후 조립까지 완료했습니다.
이슈 닫겠습니다.

Closed 2021-07-11.

Thread 23 (2021-05-28):

커뮤니케이션 파트의 양방향 통신 구현

coco0508, 2021-05-28:
# 작업 개요

-우선 양방향 통신 코드 구현은  코코아 팹에 RF모듈로 SPI통신 구현한 것이 있으니 이를 응용하면 될듯 합니다.
-> 다만 실제 적용시 시리얼 모니터에서 코드상 serial.write 한 부분이 제대로 업로드 되지 않고 있고 RF통신이 이루어 지지 않는 다는 점에서 무작정 코드를 삽입하기 보다는 단방향 통신 부터 만져보면서 코드를 이해해야 할 것 같네요.
-> 단방향 통신은 되지만 전달되는 데이터의 통제가 아직은 잘 되지 않고 있습니다.
ex) 특정 숫자를 입력하면 전송이 멈추는 것 등이 안되고 있어요.

-SPI통신에서 SS(Slave Select, 현재 보드에서는 CSN)선은 마스터인 경우에는 어디에든 꽂아도 상관없지만 슬레이브일 경우에는 UNO기준으로 10번핀에 연결해야 한다고 하네요. 이유로는 마스터와 슬레이브를 구분하기 위해서 입니다. 현재 두 모듈 다 보드의 8번핀에 연결되어 있기 때문에 작업 진행에 따라 핀번호가 변경될 수 있습니다.

# 체크 리스트

확인 해야 할 것, 해야 할 것 리스트를 작성해주세요.
- [x] 단방향통신 구현
- [x] 양방향 통신 구현
- [ ] 전송 데이터 배열형태로 구현

junhee0110, 2021-07-11:
멤버 교체로 커뮤니케이션 파트를 넘겨받았습니다.

통신은 다음과 같은 메커니즘으로 작동시킬 예정입니다.

#### 드론
- read한 정보가 없으면 계속해서 listen합니다.
- 정보가 올때까지 계속해서 listen하면 송수신 타이밍이 보정되는 것을 실험적으로 확인했습니다.
- 설정한 시간 만큼 정보를 받지 못한다면 timeout이 활성화 됩니다.
- timeout이 활성화 되면 드론이 설정한 함수를 수행하도록 합니다.
- 예를 들어 초기위치의 방향으로 비행하는 등의 함수입니다. 드론이 신호를 다시 잡을 수 있도록 합니다.

#### 조종기
- 드론으로 부터 정보를 받았는지 아닌지에 관계없이 계속해서 read와 write를 번갈아가면서 합니다.

junhee0110, 2021-07-11:
위의 내용대로 코드 구현하였고 작동 확인했습니다!
이슈닫겠습니다!

Closed 2021-07-11.

Thread 27 (2021-07-12):

PID 및 Control 재검토

junhee0110, 2021-07-12:
# 작업 개요

저번에 GY-86의 회전축이 표시된 것과 조금 다른 것을 확인하고 수정했습니다.
그렇기 때문에, control파트도 검토 및 수정해야 합니다.

# 체크 리스트

확인 해야 할 것, 해야 할 것 리스트를 작성해주세요.
- [ ] Motor 조립 관련 Document 작성
- [ ] Control 파트 코드 수정
- [ ] 전체 코드 점검

junhee0110, 2021-07-12:
Control 파트를 삭제하고 해당 내용을 loop 함수에 직접 구현했습니다.
