junhee0110/DAYONE_drone/main/control.h

#ifndef CONTROL
#define CONTROL

class motor_control {

  private:
    int pin_num;
    int motor_num;
    bool x_sign;
    bool y_sign;
    bool dir;
    float output_val = 0.0;
    
  public:
    motor_control(int pin_num, int motor_mum, bool dir);
    void cal_output(axis &x, axis &y);
    void output();
};

#endif

/*
 * Motor Number 
 *  (FORWARD)
 *    2 0
 *    3 1   
 *   y
 *   |- x
 */
