junhee0110/DAYONE_drone/(commit log)

2020-11-04 Add PID.h, PID.ino, config.h
    Check section "20-11-04" of memo.md
2020-11-10 Add sensor.ino and sensor.h
2020-11-10 Edit sea pressure to fix altitude problem
    [sensor.h]
2020-11-10 Add angle_acc in sensor.ino
2020-11-14 Add files via upload
    예를 들자면 스칼라량의 변화를 표현할 때 쓸 수 있습니다.(방향별로)
    빨간색 원의 중심(빨간색 점)이 x축, y축을 기준으로 변화합니다
2020-11-14 Add files via upload
    벡터량(화살표)의 길이, 방향을 동시에 표현하기 위한 xyz좌표계입니다.
2020-11-14 스칼라량&방향 with 시리얼통신
2021-01-06 Add motor modeling
    [드론_모터.SLDPRT]
2021-01-20 Add proto FCtrl modeling
    [A2212 13 1000KV.3dm, Drone_FCtrl.SLDDRW, Drone_FCtrl.SLDPRT, Drone_FCtrl.STL]
2021-01-29 Add body modeling
    [Drone_Body.SLDASM, Drone_Body.SLDPRT, Drone_Body.STL, Drone_FCtrl(PBoard).SLDPRT]
2021-01-31 Add body modeling for printing
    [Drone_Body(1).SLDPRT, Drone_Body(1).STL, Drone_Body(2).SLDPRT, Drone_Body(2).STL, Drone_Body(3).SLDPRT, Drone_Body(3).STL, Drone_Body(4).SLDPRT, Drone_Body(4).STL]
2021-02-10 Add Pboard base FC
    [Drone_FCtrl(PBoard).SLDPRT]
2021-02-10 Add Body V2
    [[V2]Drone_Body(1).SLDPRT, [V2]Drone_Body(1).STL, [V2]Drone_Body(2).SLDPRT, [V2]Drone_Body(2).STL, [V2]Drone_Body(3).SLDPRT, [V2]Drone_Body(3).STL, [V2]Drone_Body(4).SLDPRT, [V2]Drone_Body(4).STL]
2021-02-21 add V2.2 modeling
    [Drone_FCtrl(PBoard).SLDPRT, [V2.2]Drone_Body(1).SLDPRT, [V2.2]Drone_Body(1).STL, [V2.2]Drone_Body(2).SLDPRT, [V2.2]Drone_Body(2).STL, [V2.2]Drone_Body(3).SLDPRT, [V2.2]Drone_Body(3).STL, [V2.2]Drone_Body(4).SLDPRT]
